solderneer/ARMsat/ARMsat-poster.pdf

# ARMsat

### A fully comprehensive implementation of a 32 bit microsatellite

https://github.com/solderneer/ARMsat Project Goals

# Design of hardware components

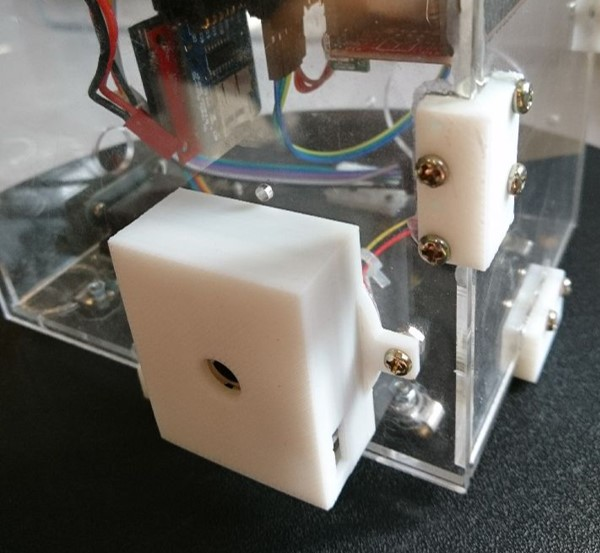
[picture p1: figure]
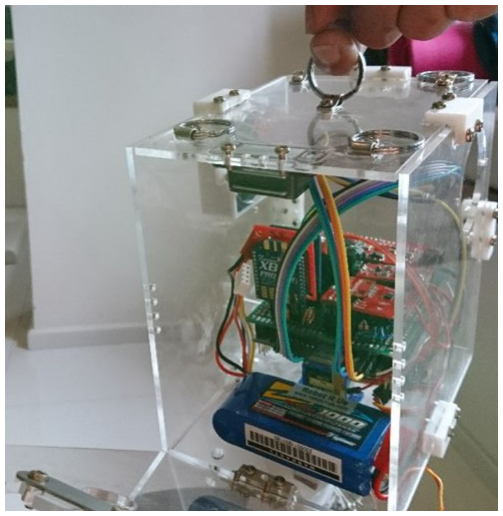
[picture p2: figure]
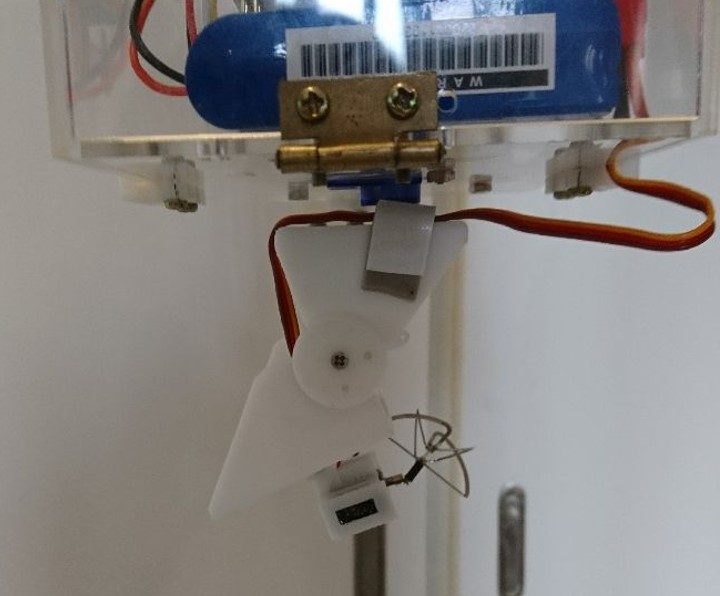
[picture p3: figure]

# Software Design

32-bit microsatellite
- Improve performance
- Faster loop time

Durable frame
- Capable of carrying a payload
- Light and compact

User-friendly ground station
- Self-sufficient control unit
- Complementary desktop app

Ventilation
Holes to allow for
better ventilation

Dust sensor
3D printed case

Pan-tilt system
2 SG90 servos
5g ultralight camera

Magnetic latch
Increased electronics accessibility

# Electronics

Primary MCU: Nucleo F411RE, Arduino Fio Onboard sensors: BMP085, TMP102, HIH-4030, GP2Y1010AU0F, MD0550
Additional Peripherals: MicroSD card slot, XBee Pro Constructed a DIY Nucleo-64 shield
- Easily removable
- One mounting point
- Components of headers
- Modularized

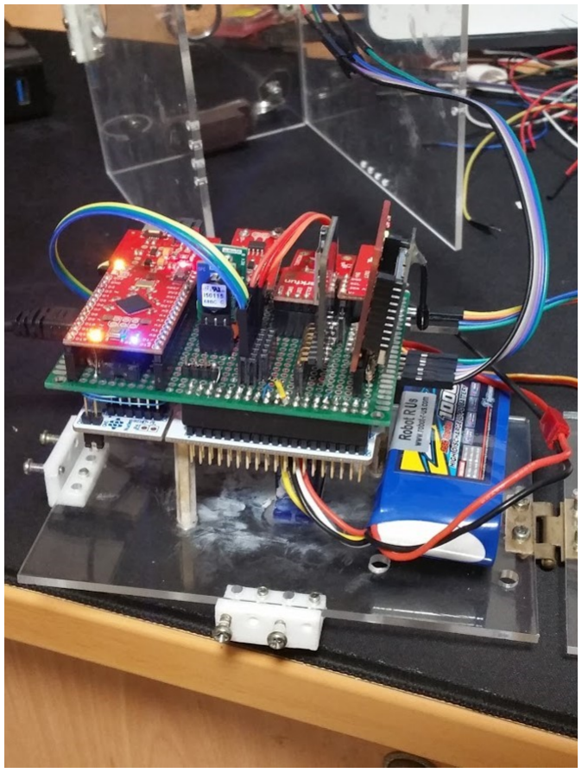
[picture p4: figure]
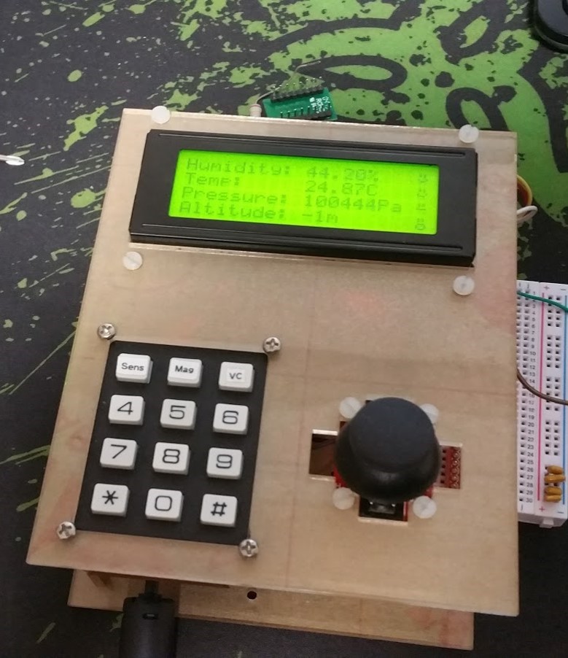
[picture p5: figure]

Electronics Design | Ground Station interface
- Firmware coded in embedded C
- Custom libraries and drivers
- More low level control
- App coded in HTML, CSS and Javascript
- Electron.js cross platform compatibility
- NPM modules for functionality

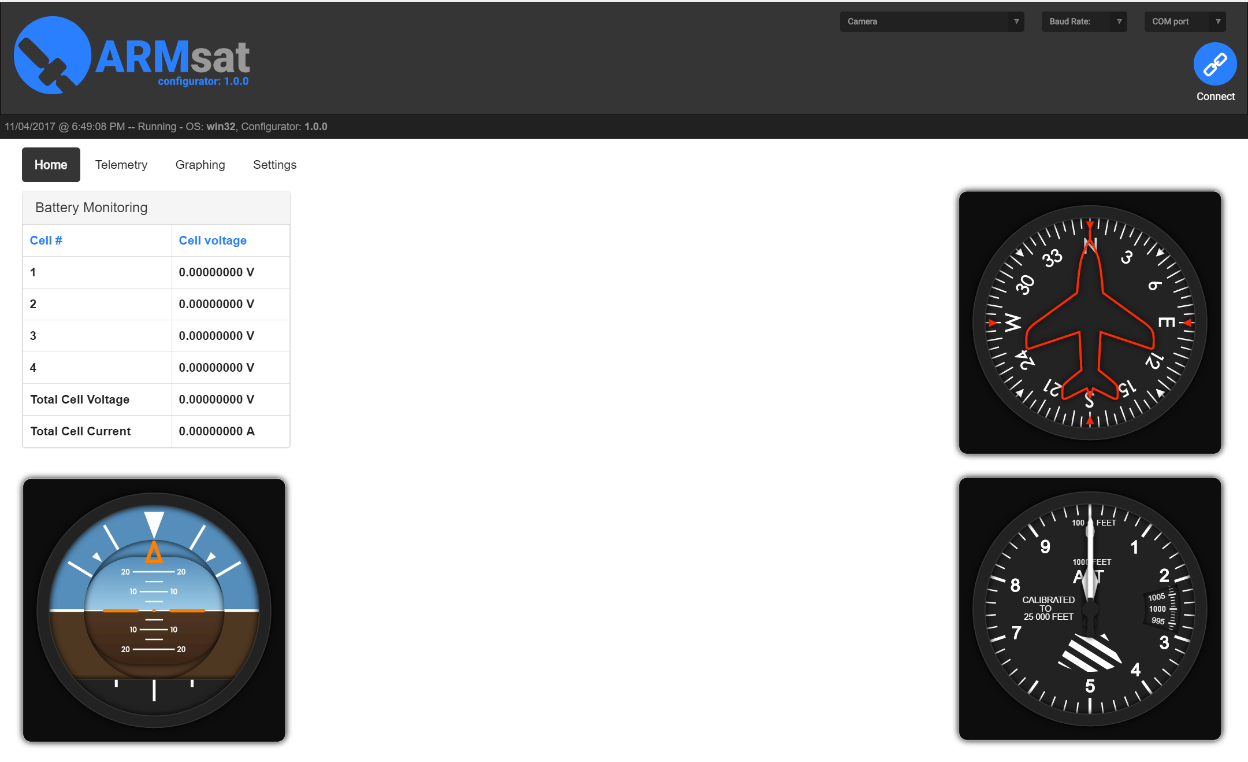
[picture p6: figure]

ARMsat configurator app screenshot

# Results

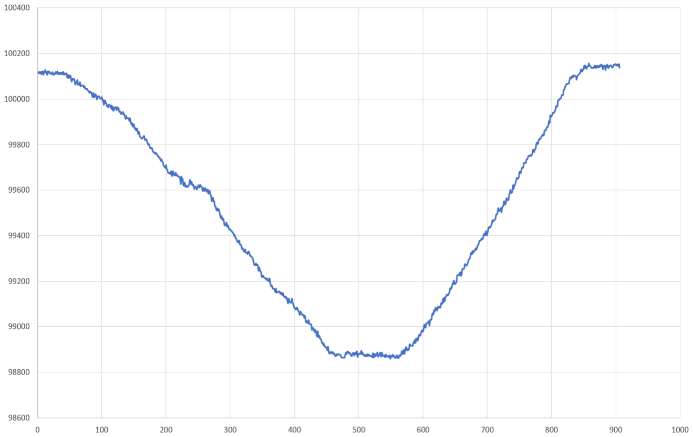
[picture p7: figure]
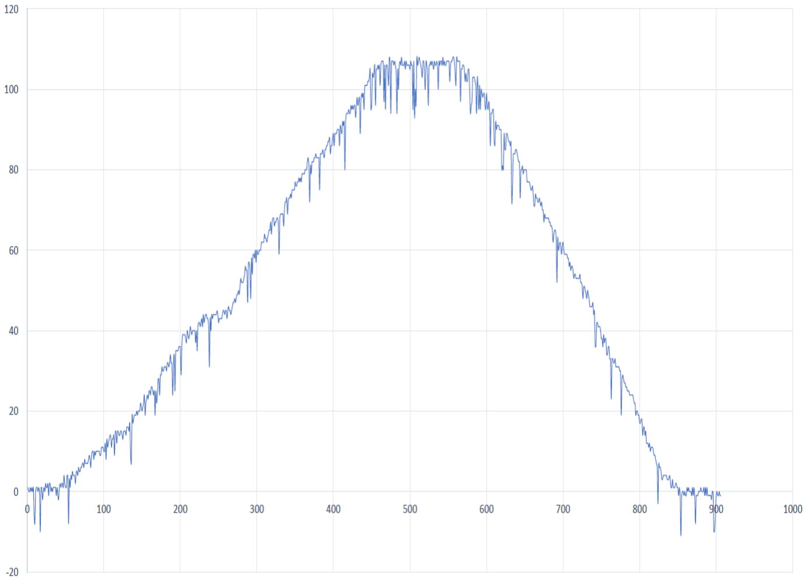
[picture p8: figure]

Altitude graph | Pressure graph

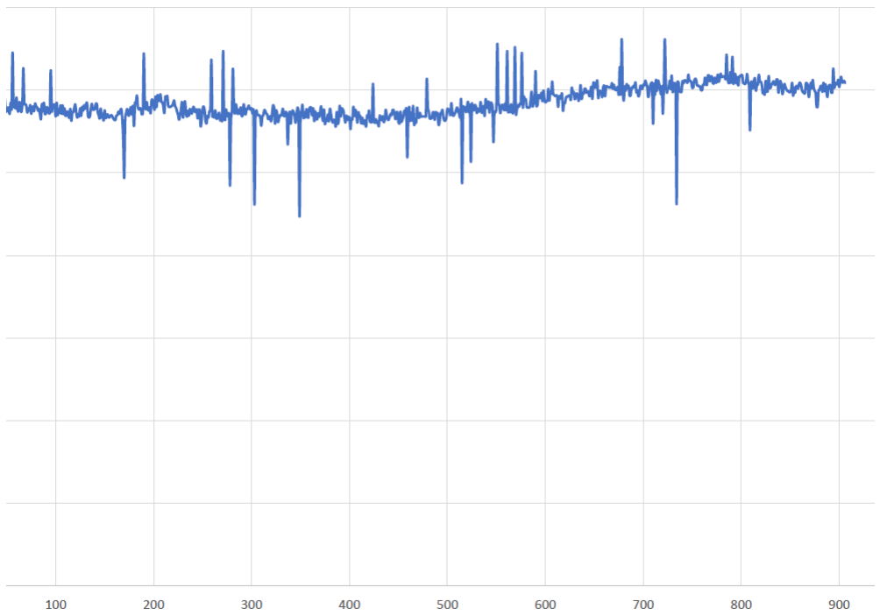
[picture p9: figure]
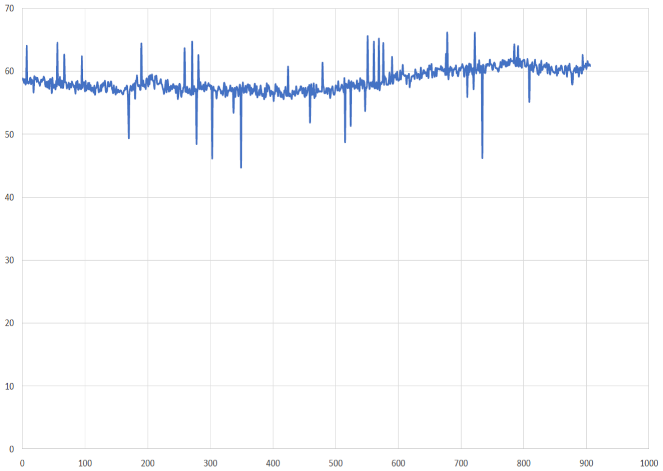
[picture p10: figure]

Temperature graph | Humidity graph

Project done by: Siidheesh Theivasigamani, Marcus Chan Wei Siang, Sundaramahalingam Sudharshan
