solderneer/ARMsat/firmware/groundstation/eg1310_base_mx.pdf

## eg1310_base_mx Project Configuration Report

# 1. Description

## 1.1. Project

Project Name | eg1310_base_mx
Board Name | NUCLEO-F411RE
Generated with: | STM32CubeMX 4.19.0
Date | 03/29/2017

## 1.2. MCU

MCU Series | STM32F4
MCU Line | STM32F411
MCU name | STM32F411RETx
MCU Package | LQFP64
MCU Pin number | 64

# 2. Pinout Configuration

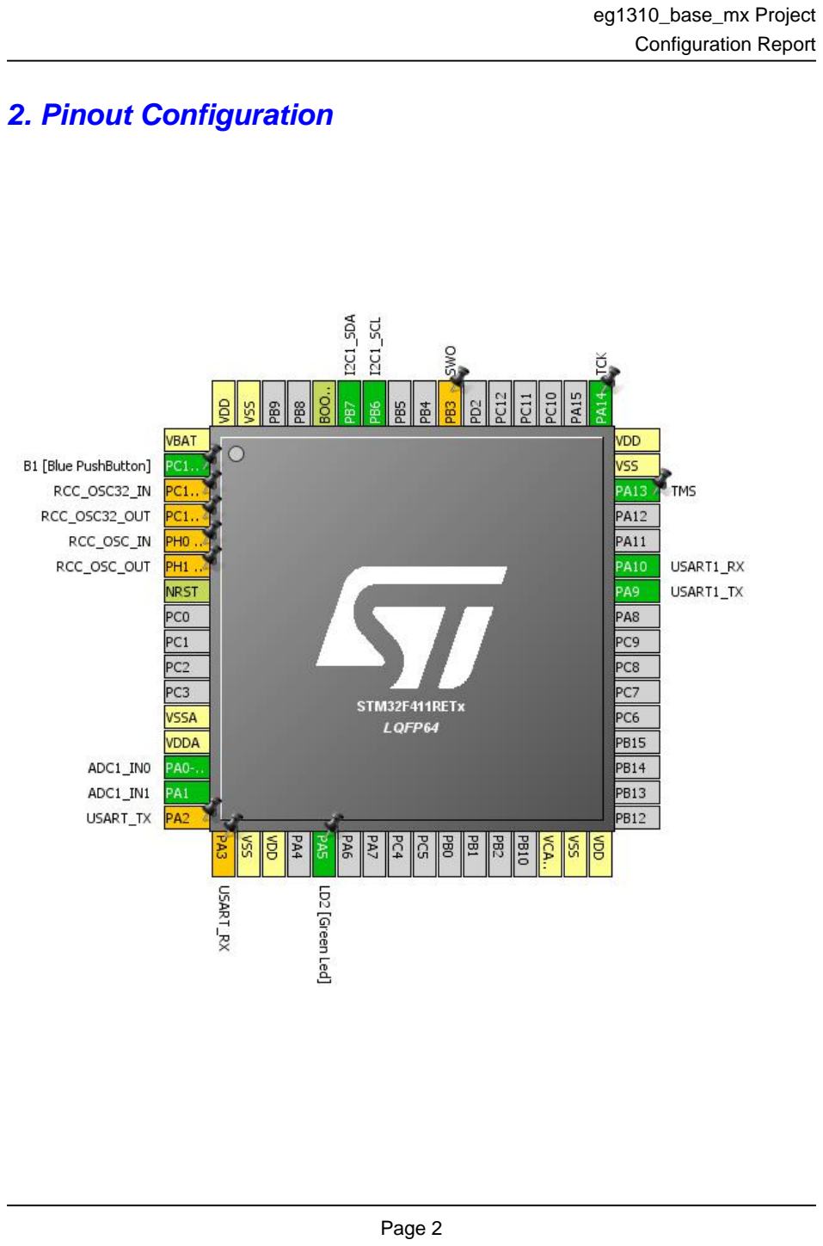
[picture p11: page 2]

# 3. Pins Configuration

Pin Number LQFP64 | Pin Name (function after reset) | Pin Type | Alternate Function(s) | Label
1 | VBAT | Power
2 | PC13-ANTI_TAMP | I/O | GPIO_EXTI13 | B1 [Blue PushButton]
3 | PC14-OSC32_IN * | I/O | RCC_OSC32_IN
4 | PC15-OSC32_OUT * | I/O | RCC_OSC32_OUT
5 | PH0 - OSC_IN * | I/O | RCC_OSC_IN
6 | PH1 - OSC_OUT * | I/O | RCC_OSC_OUT
7 | NRST | Reset
12 | VSSA | Power
13 | VDDA | Power
14 | PA0-WKUP | I/O | ADC1_IN0
15 | PA1 | I/O | ADC1_IN1
16 | PA2 * | I/O | USART2_TX | USART_TX
17 | PA3 * | I/O | USART2_RX | USART_RX
18 | VSS | Power
19 | VDD | Power
21 | PA5 ** | I/O | GPIO_Output | LD2 [Green Led]
30 | VCAP1 | Power
31 | VSS | Power
32 | VDD | Power
42 | PA9 | I/O | USART1_TX
43 | PA10 | I/O | USART1_RX
46 | PA13 | I/O | SYS_JTMS-SWDIO | TMS
47 | VSS | Power
48 | VDD | Power
49 | PA14 | I/O | SYS_JTCK-SWCLK | TCK
55 | PB3 * | I/O | SYS_JTDO-SWO | SWO
58 | PB6 | I/O | I2C1_SCL
59 | PB7 | I/O | I2C1_SDA
60 | BOOT0 | Boot
63 | VSS | Power
64 | VDD | Power

## ** The pin is affected with an I/O function * The pin is affected with a peripheral function but no peripheral mode is activated

# 4. Clock Tree Configuration

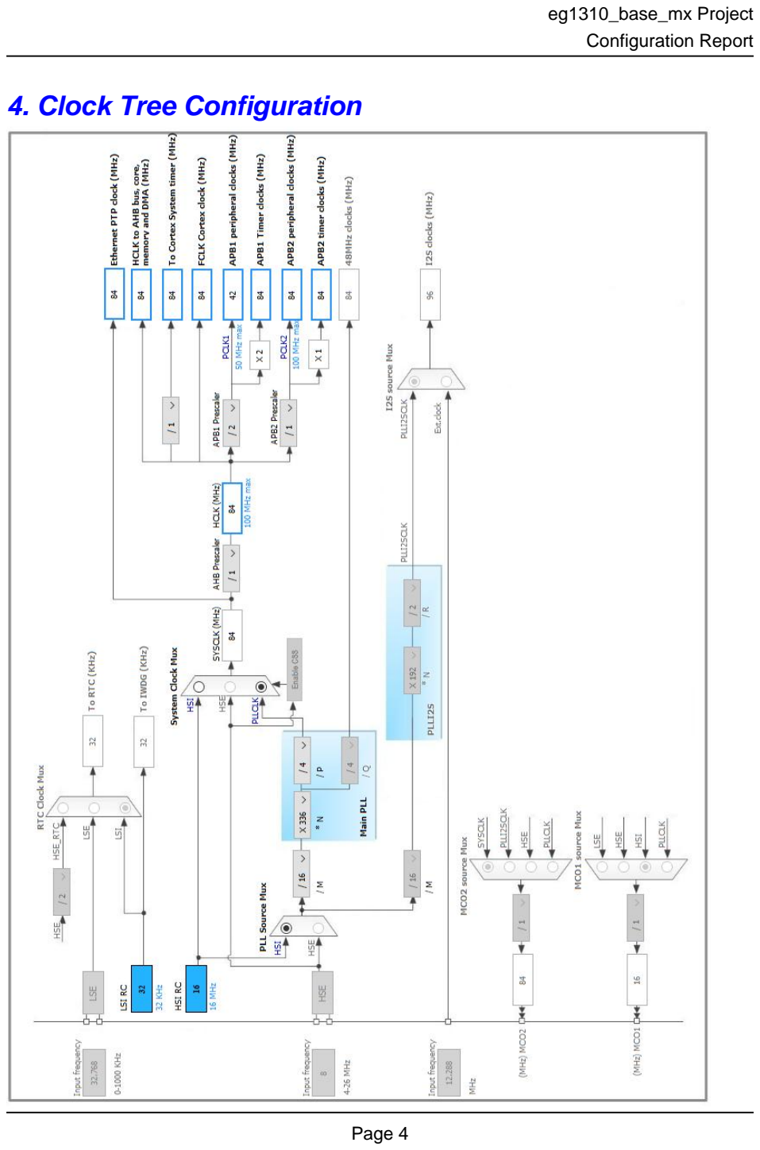
[picture p12: page 4]

# 5. IPs and Middleware Configuration

# 5.1. ADC1

## mode: IN0 mode: IN1 mode: Vrefint Channel

## 5.1.1. Parameter Settings:

### ADC_Settings:

Clock Prescaler | PCLK2 divided by 4
Resolution | 12 bits (15 ADC Clock cycles)
Data Alignment | Right alignment
Scan Conversion Mode | Disabled
Continuous Conversion Mode | Disabled
Discontinuous Conversion Mode | Disabled
DMA Continuous Requests | Disabled
End Of Conversion Selection | EOC flag at the end of single channel conversion

### ADC_Regular_ConversionMode:

Number Of Conversion | 1
External Trigger Conversion Source | Regular Conversion launched by software
External Trigger Conversion Edge | None
Rank | 1
Channel | Channel 0
Sampling Time | 3 Cycles

### ADC_Injected_ConversionMode:

Number Of Conversions | 0

### WatchDog:

Enable Analog WatchDog Mode | false

# 5.2. CRC

## mode: Activated

# 5.3. I2C1

## I2C: I2C

## 5.3.1. Parameter Settings:

### Master Features:

I2C Speed Mode | Standard Mode
I2C Clock Speed (Hz) | 100000

### Slave Features:

Clock No Stretch Mode | Disabled
Primary Address Length selection | 7-bit
Dual Address Acknowledged | Disabled
Primary slave address | 0
General Call address detection | Disabled

# 5.4. SYS

## Debug: Serial Wire Timebase Source: SysTick

# 5.5. USART1

## Mode: Asynchronous

## 5.5.1. Parameter Settings:

### Basic Parameters:

Baud Rate | 115200
Word Length | 8 Bits (including Parity)
Parity | None
Stop Bits | 1

### Advanced Parameters:

Data Direction | Receive and Transmit
Over Sampling | 16 Samples

### * User modified value

# 6. System Configuration

# 6.1. GPIO configuration

IP | Pin | Signal | GPIO mode | GPIO pull/up pull down | Max Speed | User Label
ADC1 | PA0-WKUP | ADC1_IN0 | Analog mode | No pull-up and no pull-down | n/a
| PA1 | ADC1_IN1 | Analog mode | No pull-up and no pull-down | n/a
I2C1 | PB6 | I2C1_SCL | Alternate Function Open Drain | Pull-up | Very High *
| PB7 | I2C1_SDA | Alternate Function Open Drain | Pull-up | Very High *
SYS | PA13 | SYS_JTMS-SWDIO | n/a | n/a | n/a | TMS
| PA14 | SYS_JTCK-SWCLK | n/a | n/a | n/a | TCK
USART1 | PA9 | USART1_TX | Alternate Function Push Pull | Pull-up | Very High *
| PA10 | USART1_RX | Alternate Function Push Pull | Pull-up | Very High *
Single Mapped Signals | PC14-OSC32_IN | RCC_OSC32_IN | n/a | n/a | n/a
| PC15-OSC32_OU T | RCC_OSC32_O UT | n/a | n/a | n/a
| PH0 -OSC_IN | RCC_OSC_IN | n/a | n/a | n/a
| PH1 -OSC_OUT | RCC_OSC_OUT | n/a | n/a | n/a
| PA2 | USART2_TX | Alternate Function Push Pull | No pull-up and no pull-down | Very High * | USART_TX
| PA3 | USART2_RX | Alternate Function Push Pull | No pull-up and no pull-down | Very High * | USART_RX
| PB3 | SYS_JTDO-SWO | n/a | n/a | n/a | SWO
GPIO | PC13-ANTI_TAMP | GPIO_EXTI13 | External Interrupt Mode with Falling edge trigger detection | No pull-up and no pull-down | n/a | B1 [Blue PushButton]
| PA5 | GPIO_Output | Output Push Pull | No pull-up and no pull-down | Low | LD2 [Green Led]

# 6.2. DMA configuration

## nothing configured in DMA service

# 6.3. NVIC configuration

Interrupt Table | Enable | Preenmption Priority | SubPriority
Non maskable interrupt | true | 0 | 0
Hard fault interrupt | true | 0 | 0
Memory management fault | true | 0 | 0
Pre-fetch fault, memory access fault | true | 0 | 0
Undefined instruction or illegal state | true | 0 | 0
System service call via SWI instruction | true | 0 | 0
Debug monitor | true | 0 | 0
Pendable request for system service | true | 0 | 0
System tick timer | true | 0 | 0
ADC1 global interrupt | true | 0 | 0
I2C1 event interrupt | true | 0 | 0
I2C1 error interrupt | true | 0 | 0
USART1 global interrupt | true | 0 | 0
PVD interrupt through EXTI line 16 | unused
Flash global interrupt | unused
RCC global interrupt | unused
EXTI line[15:10] interrupts | unused
FPU global interrupt | unused

### * User modified value

# 7. Power Consumption Calculator report

## 7.1. Microcontroller Selection

Series | STM32F4
Line | STM32F411
MCU | STM32F411RETx
Datasheet | 026289_Rev4

## 7.2. Parameter Selection

Temperature | 25
Vdd | null

# 8. Software Project

## 8.1. Project Settings

Name | Value
Project Name | eg1310_base_mx
Project Folder | C:\Users\sidxb\workspace\eg1310_base_mx
Toolchain / IDE | SW4STM32
Firmware Package Name and Version | STM32Cube FW_F4 V1.14.0

## 8.2. Code Generation Settings

Name | Value
STM32Cube Firmware Library Package | Copy only the necessary library files
Generate peripheral initialization as a pair of '.c/.h' files | Yes
Backup previously generated files when re-generating | No
Delete previously generated files when not re-generated | Yes
Set all free pins as analog (to optimize the power consumption) | No
