solderneer/ARMsat/(commit log)

2017-02-25 renamed directory grounstation to groundstation
2017-03-07 broke a bunch of things
    [app.js]
2017-03-08 added camera scanning, camera videofeed, consolelog system and buttonclick event
2017-03-09 added connection routine and error checking
    [app.js, utility.js]
2017-03-18 added kicad electronics file
    [ARMsat.kicad_pcb, ARMsat.sch]
2017-03-19 added table and camera
    [ARMsat.kicad_pcb, ARMsat.sch]
2017-03-19 centered camera feed
2017-03-27 added tabs switching
2017-03-27 working tab switching functionality
2017-03-28 added MPU6050 driver code
2017-03-28 Committing latest firmware revision
    - Assignment 3
    - Fixed mpu6050 driver
    [hmc.c, lcd.c, lcd.h, main.c, main.h, mpu6050.c, mpu6050.h]
2017-03-28 - Deleted obsolete groundstation code
    - Committed current revision of satellite code, less ADC, PanTilt+MPU and SPI data logging logic
2017-03-28 Added incomplete adc and servo code for testing
2017-03-28 Fixed faulty ADC code
    [main.c]
2017-03-29 added complementary filter I found somewhere
2017-03-30 Integrated comp filter, added fio sketch
2017-03-30 Committing ground station code
2017-03-30 Added preliminary support for the wind sensor, changed fio code to output to a csv file
2017-04-05 switched to latest protocol
2017-04-05 Committing major changes to ground station and satellite code Basic functionality achieved
2017-04-05 Added wind speed sensor support
2017-04-06 Added dust sensor support
