solderneer/ARMsat/(notices)

Notices in the files:
firmware/groundstation/include/main.h:
COPYRIGHT(c) 2017 STMicroelectronics
(C) COPYRIGHT STMicroelectronics *****END OF FILE
